TuftsElectricalAvionics/TR4-Kindlevin/README.md

The code repository for everything related to to the TR4 Kindlevin rocket including code for the flight computer, airbrakes and the rocket tracking antenna.
