TuftsElectricalAvionics/TR4-Kindlevin/RocketPy/SampleData.png

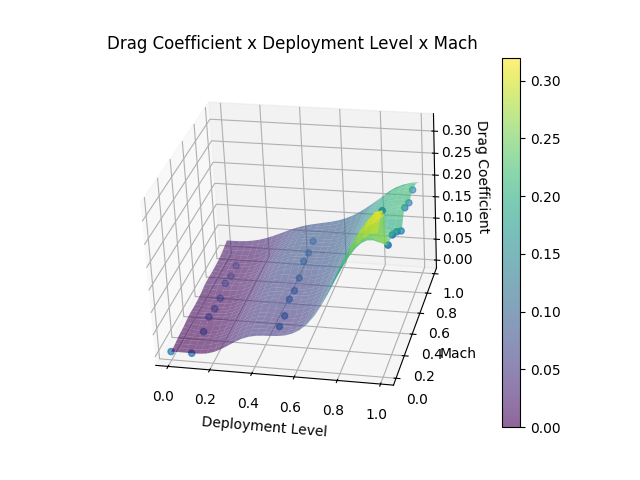
RocketPy/SampleData.png
