TuftsElectricalAvionics/TR4-Kindlevin/RocketPy/RocketPyTest/README.md

RocketPy Data based on sample sample code online

Go into AirbreaksDataTest.py or FlightSim.py to run stuff
