TuftsElectricalAvionics/TR4-Kindlevin/RocketPy/RocketPyTest/air_brakes_cd.csv

deployment_level | mach | cd
0.0 | 0.0 | 0.0
0.1 | 0.0 | 0.0
0.1 | 0.2 | 0.0
0.1 | 0.3 | 0.01
0.1 | 0.4 | 0.005
0.1 | 0.5 | 0.006
0.1 | 0.6 | 0.018
0.1 | 0.7 | 0.012
0.1 | 0.8 | 0.014
0.5 | 0.1 | 0.051
0.5 | 0.2 | 0.051
0.5 | 0.3 | 0.065
0.5 | 0.4 | 0.061
0.5 | 0.5 | 0.067
0.5 | 0.6 | 0.083
0.5 | 0.7 | 0.08
0.5 | 0.8 | 0.085
1.0 | 0.1 | 0.32
1.0 | 0.2 | 0.225
1.0 | 0.3 | 0.225
1.0 | 0.4 | 0.21
1.0 | 0.5 | 0.19
1.0 | 0.6 | 0.22
1.0 | 0.7 | 0.21
1.0 | 0.8 | 0.218
