TuftsElectricalAvionics/TR4-Kindlevin/TR3V4_Kicad/TR3V4.kicad_pcb

## KiCad design TR3V4_Kicad/TR3V4.kicad_pcb (2025-11-16)

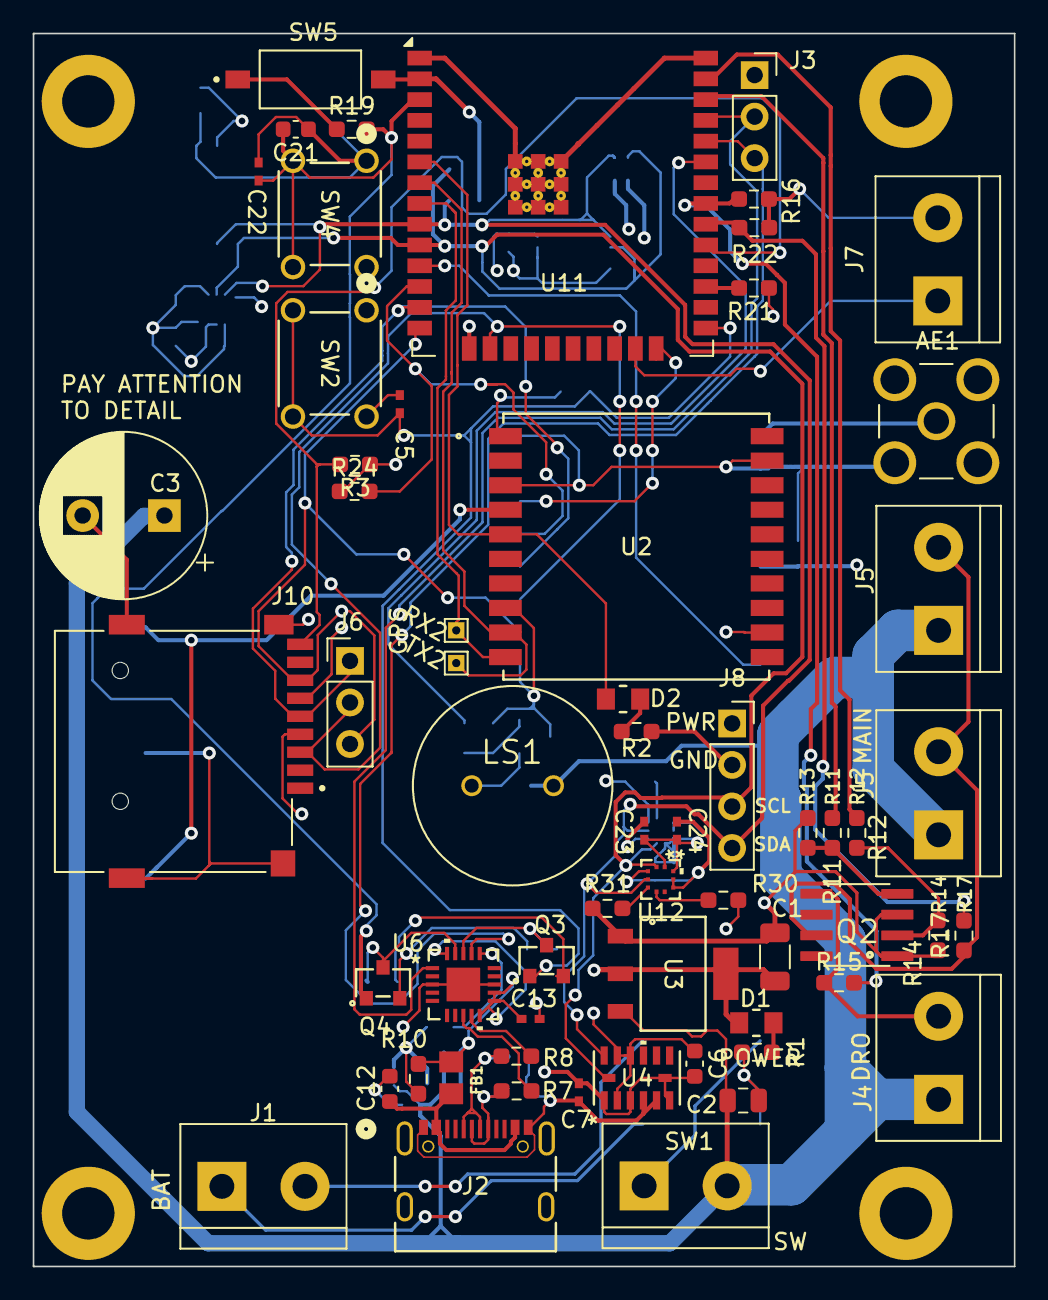
[picture p2: board TR3V4.kicad_pcb from above]

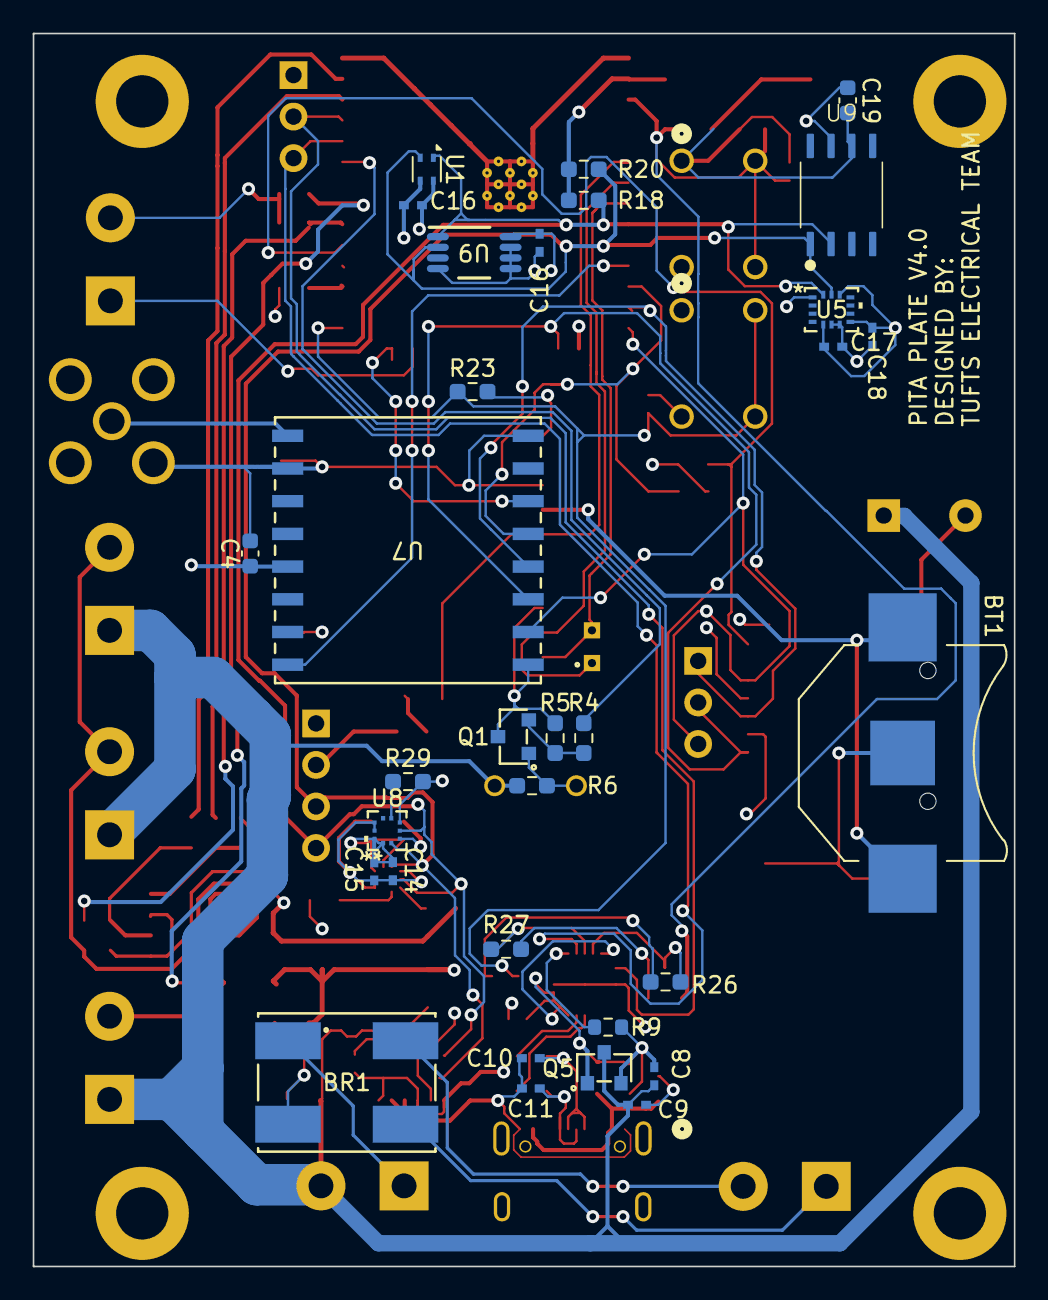
[picture p3: board TR3V4.kicad_pcb from below]

Board: 4 copper layers, 60.0 x 75.4 mm, 93 parts (32 on the bottom side), 55 nets.

Parts:
AE1: Antenna; GRADCONN_RFPC-SMA28-F
BR1: Z4DGP406L-HF; Z4DGP406L-HF_footprint_N
BT1: 3.0 Coin Cell; BAT_BK-885
C1: 100 uF; C_1206_3216Metric
C2: 10 uF; C_0805_2012Metric
C3: 2200 uF; CP_Radial_D10.0mm_P5.00mm
C4, C6, C19, C21: 1 uF; C_0603_1608Metric
C5, C7, C8, C9, C14, C15, C16, C16#2, C17, C18, C22, C23, C24: 0.1 uF; CAP_CL05_SAM
C10, C11: 47pf; G-155_MUR
C12: 10 nf; C_0603_1608Metric
C13: 100 nf; CAP_CL05_SAM
D1, D2: LED; 150080RS75000_WRE
FB1: FerriteBead; FB_MI0805K400R-10
J1, J4, J5, J5#2, J7: Screw_Terminal_01x02; TerminalBlock_bornier-2_P5.08mm
J2: USB4105-GF-A; USB4105_GCT
J3: Conn_01x03_Pin; PinSocket_1x03_P2.54mm_Vertical
J6: Conn_01x03_Pin; PinHeader_1x03_P2.54mm_Vertical
J8: Conn_01x04_Pin; PinSocket_1x04_P2.54mm_Vertical
J10: MSD-4-A; CUI_MSD-4-A
LS1: PS1240P02BT; XDCR_PS1240P02BT
Q1, Q3, Q4, Q5: NPN; SMT_BJT_SP2
Q2: AO4838; MOSFET_Smt_2_sp2
R1: 1500 Ohm; R_0603_1608Metric_Pad0.98x0.95mm_HandSolder
R2: 1.5K Ohm; R_0603_1608Metric_Pad0.98x0.95mm_HandSolder
R3, R18, R20, R23, R24: 4.7k; R_0603_1608Metric_Pad0.98x0.95mm_HandSolder
R4, R11, R12: 100; R_0603_1608Metric_Pad0.98x0.95mm_HandSolder
R5, R10, R13, R14, R19, R21, R26, R27, R29, R30: 10k; R_0603_1608Metric_Pad0.98x0.95mm_HandSolder
R6: 1.5k; R_0603_1608Metric_Pad0.98x0.95mm_HandSolder
R7, R8: 27R; R_0603_1608Metric_Pad0.98x0.95mm_HandSolder
R9: 1k; R_0603_1608Metric
R15, R17: 130k; R_0603_1608Metric_Pad0.98x0.95mm_HandSolder
R16, R22, R31: 100k; R_0603_1608Metric_Pad0.98x0.95mm_HandSolder
RX2: TestPoint_Small; TestPoint_THTPad_1.0x1.0mm_Drill0.5mm
SW1: SW_SPST; TerminalBlock_bornier-2_P5.08mm
SW2, SW4: reset; SW_TS02-66-50-BK-XXX-LCR-D_CUD
SW5: Enable Switch; SW_DS04-254-2-01BK-SMT
TX2: TestPoint_Small; TestPoint_THTPad_1.0x1.0mm_Drill0.5mm
U1: Env. Temp; Sensirion_DFN-4_1.5x1.5mm_P0.8mm_SHT4x_NoCentralPad
U2: GPS; 5186_footprint_N
U3: LDL1117S33R; SOT223_STM
U4: High g Acceleromter; ADXL375BCCZ_footprint_N
U5: IMU; BMI323_BOS
U6: FT231XQ-R; FT231XQ-R_footprint_N
U7: COM-13909; COM-13909_footprint_N
U8: Barometer 1; QFN10_BMP581_BOS
U9: TMP1075DGKR; TMP1075DGKR_footprint_N
U9#2: Magnetometer; MAGNETO-MLX90395KDC
U11: ESP32-WROOM-32E-N8; ESP32-WROOM-32E
U12: Barometer 2; QFN10_BMP581_BOS

Connections:
+3.3V: C1.2, C4.2, C6.2, C7.2, C14.2, C15.1, C16.1, C16#2.2, C17.1, C18.1, C19.1, C23.2, C24.1, D1.2 (A), J8.1, J10.4 (VDD), R3.1, R18.1, R20.1, R21.2, R23.2, R24.1, R29.2, R30.2, SW5.2, U1.3 (VDD), U2.1 (VCC), U3.2 (VOUT), U3.4 (VOUT), U4.1 (VDD_I/O), U4.3 (RESERVED), U4.6 (VS), U4.7 (*CS), U5.5 (VDDIO), U5.8 (VDD), U5.12 (CSB), U7.13 (3.3V), U8.1 (VDDIO), U8.5 (SDO), U8.10 (VDD), U9.8 (V+), U9#2.7 (Vdd), U11.2 (3V3), U12.1 (VDDIO), U12.10 (VDD)
+7.5V: C2.2, C3.1, C8.1, C9.1, J4.1, J5.1, J5#2.1, LS1.2, Q5.3 (E), R6.1, SW1.2 (B), U3.3 (VIN)
/DN: C10.1, J2.A7 (DN1), J2.B7 (DN2), R8.1
/DP: C11.1, J2.A6 (DP1), J2.B6 (DP2), R7.1
/Detect: R9.2, U6.16 (CBUS3)
/Drouge: R11.1, U11.36 (IO22)
/I2C_SCL: J8.3, R20.2, U1.2 (SCL), U4.14 (SCL/SCLK), U5.13 (SCX), U8.2 (SCK), U9.2 (SCL), U9#2.1 (SCL), U11.10 (IO25), U12.2 (SCK)
/I2C_SDA: J8.4, R18.2, U1.1 (SDA), U4.13 (SDA/SDI/SDIO), U5.14 (SDX), U8.4 (SDI), U9.1 (SDA), U9#2.2 (SDA), U11.9 (IO33), U12.4 (SDI)
/LORA_CS: R24.2, U7.5 (NSS), U11.12 (IO27)
/LORA_Data02: U7.16 (DIO02), U11.11 (IO26)
/LORA_Reset: U7.6 (RESET), U11.24 (IO2)
/Main: R12.1, U11.37 (IO23)
/Motor_PWM: J7.1, U11.23 (IO15)
/SPICLK: J6.1, J10.5 (CLK), U7.4 (SCK), U11.13 (IO14)
/SPI_MISO: J6.3, J10.7 (DAT0), U7.2 (MISO), U11.14 (IO12)
/SPI_MOSI: J6.2, J10.3 (CMD), U7.3 (MOSI), U11.16 (IO13)
/UART_RX: J3.3, U6.17 (TXD), U11.34 (RXD0)
/UART_TX: J3.2, U6.1 (RXD), U11.35 (TXD0)
/VBUS: C12.1, FB1.1, J2.A4-B9 (VBUS), J2.B4-A9 (VBUS)
/VCC: C13.1, FB1.2, Q5.1 (C), R10.2, U6.10 (3V3OUT), U6.11 (RESET#), U6.12 (VCC), U6.20 (VCCIO)
/cont drouge: R15.2, R16.1, U11.31 (IO19)
/cont main: R17.2, R22.1, U11.30 (IO18)
/cs_sd: J10.CD, R3.2, U11.29 (IO5)
/fix: D2.2 (A), U2.5 (3D-FIX), U11.6 (IO34)
/flash: C5.2, Q3.1 (C), R23.1, SW2.2, U11.25 (IO0)
/gps_rx: RX2.1, U2.10 (RX0), U11.8 (IO32)
/gps_tx: TX2.1, U2.9 (TX0), U11.7 (IO35)
/piezo: R4.2, U11.33 (IO21)
/reset: C21.2, C22.2, Q4.1 (C), R19.2, SW4.2, U11.3 (EN)
Earth: AE1.G1, AE1.G2, AE1.G3, AE1.G4, BR1.4, BT1.2 (-), C1.1, C2.1, C3.2, C4.1, C5.1, C6.1, C7.1, C9.2, C10.2, C11.2, C12.2, C13.2, C14.1, C15.2, C16.2, C16#2.1, C17.2, C18.2, C19.2, C21.1, C22.1, C23.1, C24.2, J2.A1-B12 (GND), J2.B1-A12 (GND), J3.1, J7.2, J8.2, J10.6 (VSS), J10.G1 (COVER_GND), J10.G2 (COVER_GND__1), J10.G3 (COVER_GND__2), J10.G4 (COVER_GND__3), Q1.3 (E), Q2.1, Q2.3, R1.2, R2.2, R5.1, R13.1, R14.1, R16.2, R22.2, R31.2, SW2.1, SW4.1, U1.4 (VSS), U2.3 (GND), U2.8 (GND), U2.12 (GND), U2.19 (GND), U3.1 (GND), U4.2 (GND), U4.4 (GND), U4.5 (GND), U4.11 (RESERVED), U4.12 (SDO/ALT_ADDRESS), U5.1 (SDO), U5.6 (GNDIO), U5.7 (GND), U6.3 (GND), U6.13 (GND), U6.21 (GND), U7.1 (GND), U7.8 (GND), U7.10 (GND), U8.3 (VSS), U8.8 (VSS), U8.9 (VSS), U9.4 (GND), U9.5 (A2), U9.6 (A1), U9.7 (A0), U9#2.6 (Vss), U11.1 (GND), U11.15 (GND), U11.38 (GND), U11.39 (GND), U12.3 (VSS), U12.8 (VSS), U12.9 (VSS)
unnamed: BT1.1 (+), U2.4 (VBACKUP)
unnamed: D1.1 (K), R1.1
unnamed: D2.1 (K), R2.1
unnamed: BR1.3, J1.1
unnamed: BR1.2, J1.2
unnamed: J4.2, Q2.5, R15.1
unnamed: J5.2, J5#2.2, Q2.7, R17.1
unnamed: Q1.2 (B), R4.1, R5.2
unnamed: LS1.1, Q1.1 (C), R6.2
unnamed: Q2.2, R12.2, R14.2
unnamed: Q2.4, R11.2, R13.2
unnamed: Q3.2 (B), R26.1
unnamed: Q3.3 (E), R27.2, U6.18 (DTR#)
unnamed: Q4.2 (B), R27.1
unnamed: Q4.3 (E), R26.2, U6.19 (RTS#)
unnamed: C8.2, Q5.2 (B), R9.1, R10.1
unnamed: R19.1, SW5.1
unnamed: BR1.1, SW1.1 (A)
unnamed: R8.2, U6.9 (USBDM)
unnamed: R7.2, U6.8 (USBDP)
unnamed: AE1.1, U7.9 (ANT)
unnamed: R29.1, U8.6 (CSB)
unnamed: R21.1, U11.27 (IO16)
unnamed: R30.1, U12.6 (CSB)
unnamed: R31.1, U12.5 (SDO)
