TuftsElectricalAvionics/TR4-Kindlevin/flight-computer/esp-idf-port/main/main.cpp

#include <cstdio>
#include "sdkconfig.h"
#include "freertos/FreeRTOS.h"
#include "freertos/task.h"
#include "esp_log.h"
#include "computer/computer.h"
#include "driver/i2c_master.h"
#include "i2c/BMI323.h"
#include "i2c/BMP581.h"
#include "i2c/high_g_accel.h"
#include "i2c/I2C.h"
#include "i2c/MLX90395.h"
#include "i2c/segment7.h"
#include "i2c/TMP1075.h"
#include "errors.h"
#include "sd.h"


static const char *TAG = "main";

using namespace seds::errors;

struct lt2_arg {
    int id;
    TaskHandle_t handle;
};

void log_task(void*);
void log_task_2(void*);

extern "C" void app_main()
{
    ESP_LOGI(TAG, "Hello!");

    auto i2c = seds::I2C::create();
    ESP_LOGI(TAG, "I2C initialized successfully");

    // should we have a template function for calling `create`?

    seds::BMP581 baro_sensor_1 = unwrap(seds::BMP581::create( unwrap(i2c->get_device(seds::BMP581::address_1)) ));
    vTaskDelay(pdMS_TO_TICKS(10)); // otherwise i2c gets angry about NACKs

    seds::BMP581 baro_sensor_2 = unwrap(seds::BMP581::create( unwrap(i2c->get_device(seds::BMP581::address_2)) ));
    vTaskDelay(pdMS_TO_TICKS(10)); 

    //auto disp = seds::TCA6507( unwrap(i2c->get_device(0x45))); //  figure out how this works exactly!
    // remember that we need two busses - one just controls one of the 7-segment devices

    seds::BMI323 imu = unwrap(seds::BMI323::create( unwrap(i2c->get_device(seds::BMI323::default_address)) ));
    if (imu.is_connected()) {
        ESP_LOGI(TAG, "imu connected!");
    } else {
        ESP_LOGE(TAG, "imu not connected!");
    }
   
    seds::HighGAccel high_g = unwrap(seds::HighGAccel::create( unwrap(i2c->get_device(seds::HighGAccel::default_address)) ));
    if (high_g.is_connected()) {
        ESP_LOGI(TAG, "high g accel connected!");
    } else {
        ESP_LOGE(TAG, "high g accel not connected!");
    }

    //seds::MLX90395 mag_sensor = unwrap(seds::MLX90395::create( unwrap(i2c->get_device(seds::MLX90395::default_address)) ));
    seds::TMP1075 temp_sensor = unwrap(i2c->get_device<seds::TMP1075>());
    if (temp_sensor.is_connected()) {
        ESP_LOGI(TAG, "temp sensor connected!");
    } else {
        ESP_LOGE(TAG, "temp sensor not connected!");
    }

    
    auto baro_data_try = baro_sensor_1.read_data();
    auto baro_data_try_2 = baro_sensor_2.read_data();
    if (!baro_data_try.has_value() || !baro_data_try_2.has_value()) {
        ESP_LOGE(TAG, "baro data read failed");
    } else {
        seds::BarometerData data1 = baro_data_try.value();
        seds::BarometerData data2 = baro_data_try_2.value();
        ESP_LOGI(TAG, "baro 1 temp: %f, baro 2 temp: %f, baro 1 pressure: %f, baro 2 pressure: %f", 
            data1.baro_temp, data2.baro_temp, data1.pressure, data2.pressure);
    }
    
    auto high_g_data_try = high_g.read_acceleration();
    auto imu_data = imu.read_imu();
    if (!high_g_data_try.has_value() || !imu_data.has_value()) {
        ESP_LOGE(TAG, "high g or imu data read failed");
    } else {
        seds::HighGAccelData data1 = high_g_data_try.value();
        seds::IMUData data2 = imu_data.value();
        ESP_LOGI(TAG, "imu ax: %f, high g ax: %f, imu ay: %f, high g ay: %f, imu az: %f, high g az: %f", 
            data2.ax, data1.h_ax, data2.ay, data1.h_ay, data2.az, data1.h_az);
    }
    
    seds::SDCard sd = unwrap(seds::SDCard::create());

    auto fc = seds::FlightComputer {
        .baro1 = std::move(baro_sensor_1),
        .baro2 = std::move(baro_sensor_2),
        .imu = std::move(imu),
        .high_g_accel = std::move(high_g),
        //.mag = std::move(mag_sensor),
        .temp = std::move(temp_sensor),
        .sd = std::move(sd)
    };

    //Allow other core to finish initialization
    vTaskDelay(pdMS_TO_TICKS(100));

    auto init_res = fc.init();
    fc.process(10, true);
}

static void spin_iteration(int);

void log_task(void* ptr) {
    TaskHandle_t handle = *(TaskHandle_t *)ptr;

    struct timeval tv_now;
    for (int i = 0; true; i++) {
        gettimeofday(&tv_now, NULL);
        int64_t time_ms_orig = (int64_t)tv_now.tv_sec * 1000L + (int64_t)tv_now.tv_usec / 1000L;
        int64_t time_ms = time_ms_orig;
        while (time_ms - time_ms_orig < 100) {
            spin_iteration(100);
            gettimeofday(&tv_now, NULL);
            time_ms = (int64_t)tv_now.tv_sec * 1000L + (int64_t)tv_now.tv_usec / 1000L;
        }

        ESP_LOGI("other core task", "iteration: %d, time: %lld, core: %d", i, time_ms, xTaskGetCoreID(handle));
    }
}

void log_task_2(void *ptr) {
    lt2_arg arg = *(lt2_arg *)ptr;

    struct timeval tv_now;
    char tag[100];
    snprintf(tag, 100, "task #%d", arg.id);
    for (int i = 0; true; i++) {
        gettimeofday(&tv_now, NULL);
        int64_t time_ms = (int64_t)tv_now.tv_sec * 1000L + (int64_t)tv_now.tv_usec / 1000L;
        ESP_LOGI(tag, "iteration: %d, time: %lld, core: %d", i, time_ms, xTaskGetCoreID(arg.handle));
    }
}

static void spin_iteration(int spin_iter_num)
{
    for (int i = 0; i < spin_iter_num; i++) {
        __asm__ __volatile__("NOP");
    }
}
