TuftsElectricalAvionics/TR4-Kindlevin/(commit log)

2025-10-02 first operational board
2025-10-13 docs: document i2c abort condition
2025-10-14 Update and rename RocketPy/air_brakes_cd.csv to RocketPy/RocketPyTest/air_brakes_cd.csv
    [air_brakes_cd.csv]
2025-10-14 Update and rename RocketPy/powerOffDragCurve.csv to RocketPy/RocketPyTest/powerOffDragCurve.csv
    [powerOffDragCurve.csv]
2025-10-14 Update and rename RocketPy/powerOnDragCurve.csv to RocketPy/RocketPyTest/powerOnDragCurve.csv
    [powerOnDragCurve.csv]
2025-10-17 refactor: move error in TRY() macro
    [errors.h]
2025-10-19 WIP: add high-g accel (need to switch to new I2C functions)
2025-10-19 Use I2C write functions that will exist
2025-10-19 refactor: resolve review comments
    [TMP1075.cpp, TMP1075.h]
2025-11-14 temp & magnetometer
2025-11-16 New KiCad version control
    [TR3V4-B_Cu.gbr, TR3V4-B_Mask.gbr, TR3V4-B_Paste.gbr, TR3V4-B_Silkscreen.gbr, TR3V4-Edge_Cuts.gbr, TR3V4-F_Cu.gbr, TR3V4-F_Mask.gbr, TR3V4-F_Paste.gbr]
2025-11-16 Add new imu sensor and config code
2025-11-16 Add very basic 7-segment driver
2025-11-23 Add class for barometer sensors
2026-02-01 Fix some compile errors
    [BMI323.cpp, BMI323.h, BMP581.cpp, MLX90395.cpp, high_g_accel.cpp]
2026-02-08 Fix all remaining compiler errors
    [BMP581.h, MLX90395.cpp, MLX90395.h, segment7.cpp, segment7.h]
2026-02-08 Fix compiler errors for sd
    [errors.h, main.cpp, sd.cpp, sd.h, utils.h]
2026-02-08 fix some warnings about missing initializers
    [sd.cpp]
2026-02-08 initialize all sensors
2026-02-08 Only start 7segment timer if it isn't already running
2026-02-15 Add basic imu writing code
2026-02-21 WIP fix csv and imu settings
    [BMI323.cpp, main.cpp, sd.cpp, sd.h]
2026-02-22 WIP baro sensors
2026-03-03 WIP print sensor data in different thread
2026-03-15 mount and unmount twice
